DvidMakesThings/HW_BladeCoreMxx/BladeCore-M40/images/BladeCore-M40-Schematics-2.png

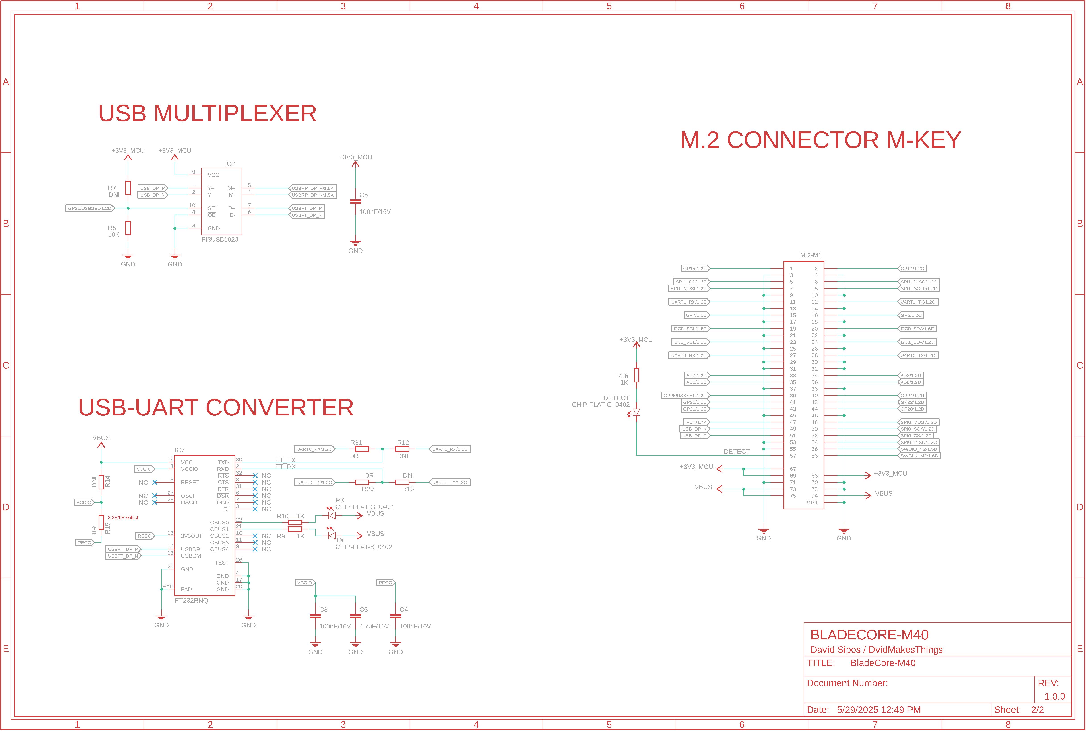
BladeCore-M40/images/BladeCore-M40-Schematics-2.png
