DvidMakesThings/HW_BladeCoreMxx/BladeCore-M40/images/BladeCore-M40_3D-2.png

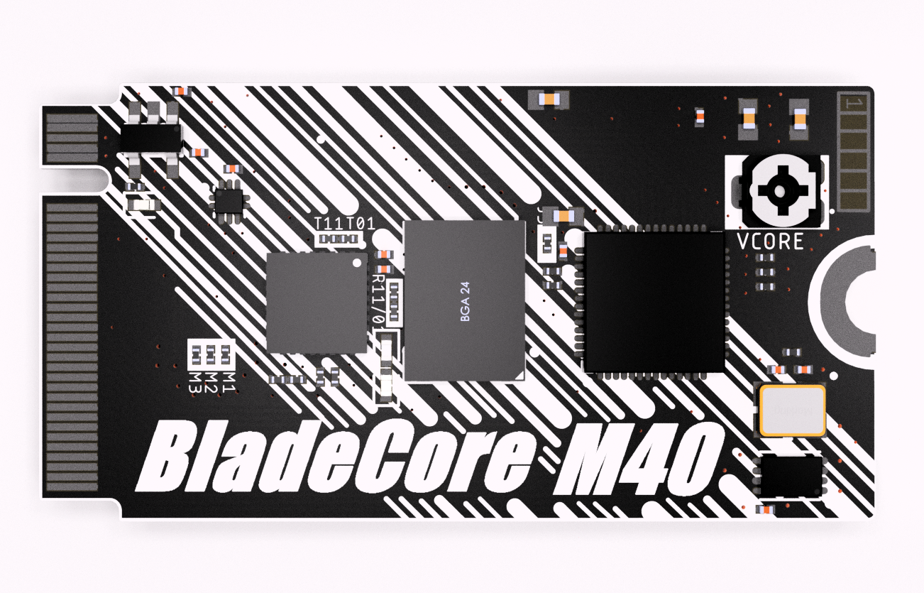
BladeCore-M40/images/BladeCore-M40_3D-2.png
