DvidMakesThings/HW_BladeCoreMxx/BladeCore-M40/images/PCB/Layer-1.png

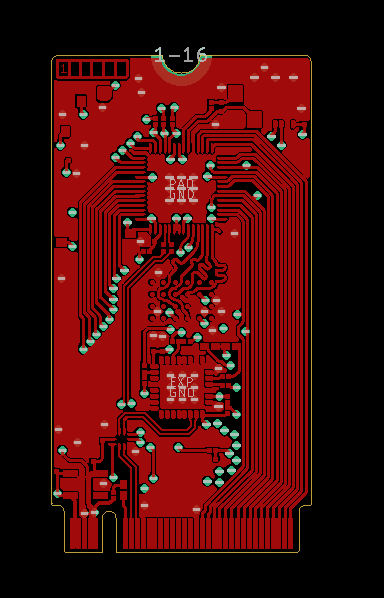
BladeCore-M40/images/PCB/Layer-1.png
