DvidMakesThings/HW_BladeCoreMxx/BladeCore-M40/images/PCB/Layer-2.png

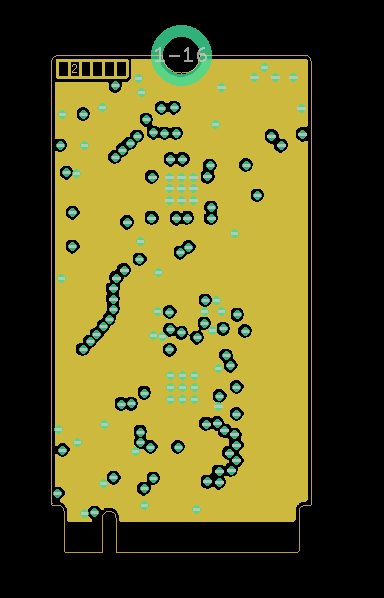
BladeCore-M40/images/PCB/Layer-2.png
