DvidMakesThings/HW_BladeCoreMxx/BladeCore-M40/images/PCB/Layer-3.png

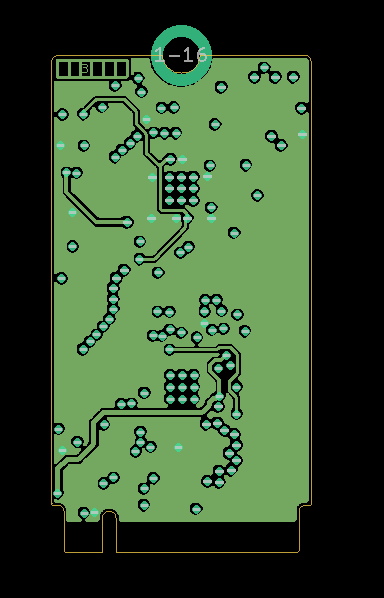
BladeCore-M40/images/PCB/Layer-3.png
