DvidMakesThings/HW_BladeCoreMxx/BladeCore-M40/images/PCB/Layer-4.png

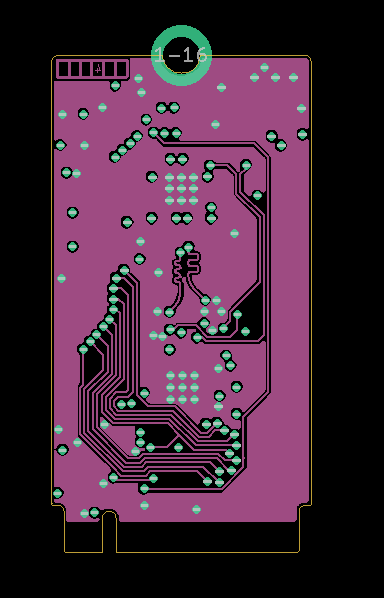
BladeCore-M40/images/PCB/Layer-4.png
