DvidMakesThings/HW_BladeCoreMxx/BladeCore-M40/images/PCB/Layer-6.png

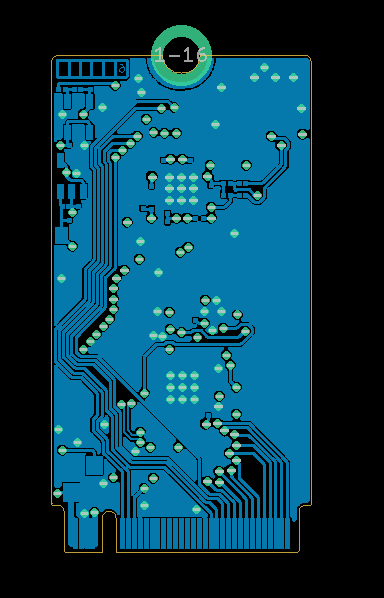
BladeCore-M40/images/PCB/Layer-6.png
