DvidMakesThings/HW_BladeCoreMxx/BladeCore-M40/images/PCB/Silkscreen_Bottom.png

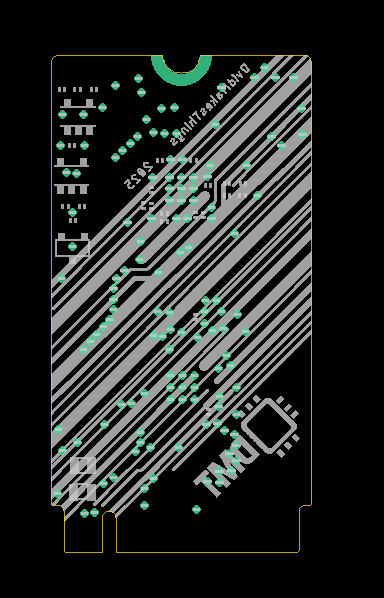
BladeCore-M40/images/PCB/Silkscreen_Bottom.png
