DvidMakesThings/HW_BladeCoreMxx/BladeCore-M40/images/PCB/Silkscreen_Top.png

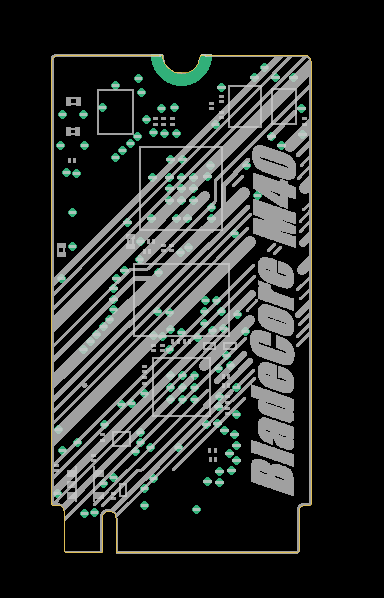
BladeCore-M40/images/PCB/Silkscreen_Top.png
