DvidMakesThings/HW_BladeCoreMxx/BladeCore-M54/src/PDF/BladeCore-M40_Schematics.pdf

# 3.3 VBUS-LDO

A

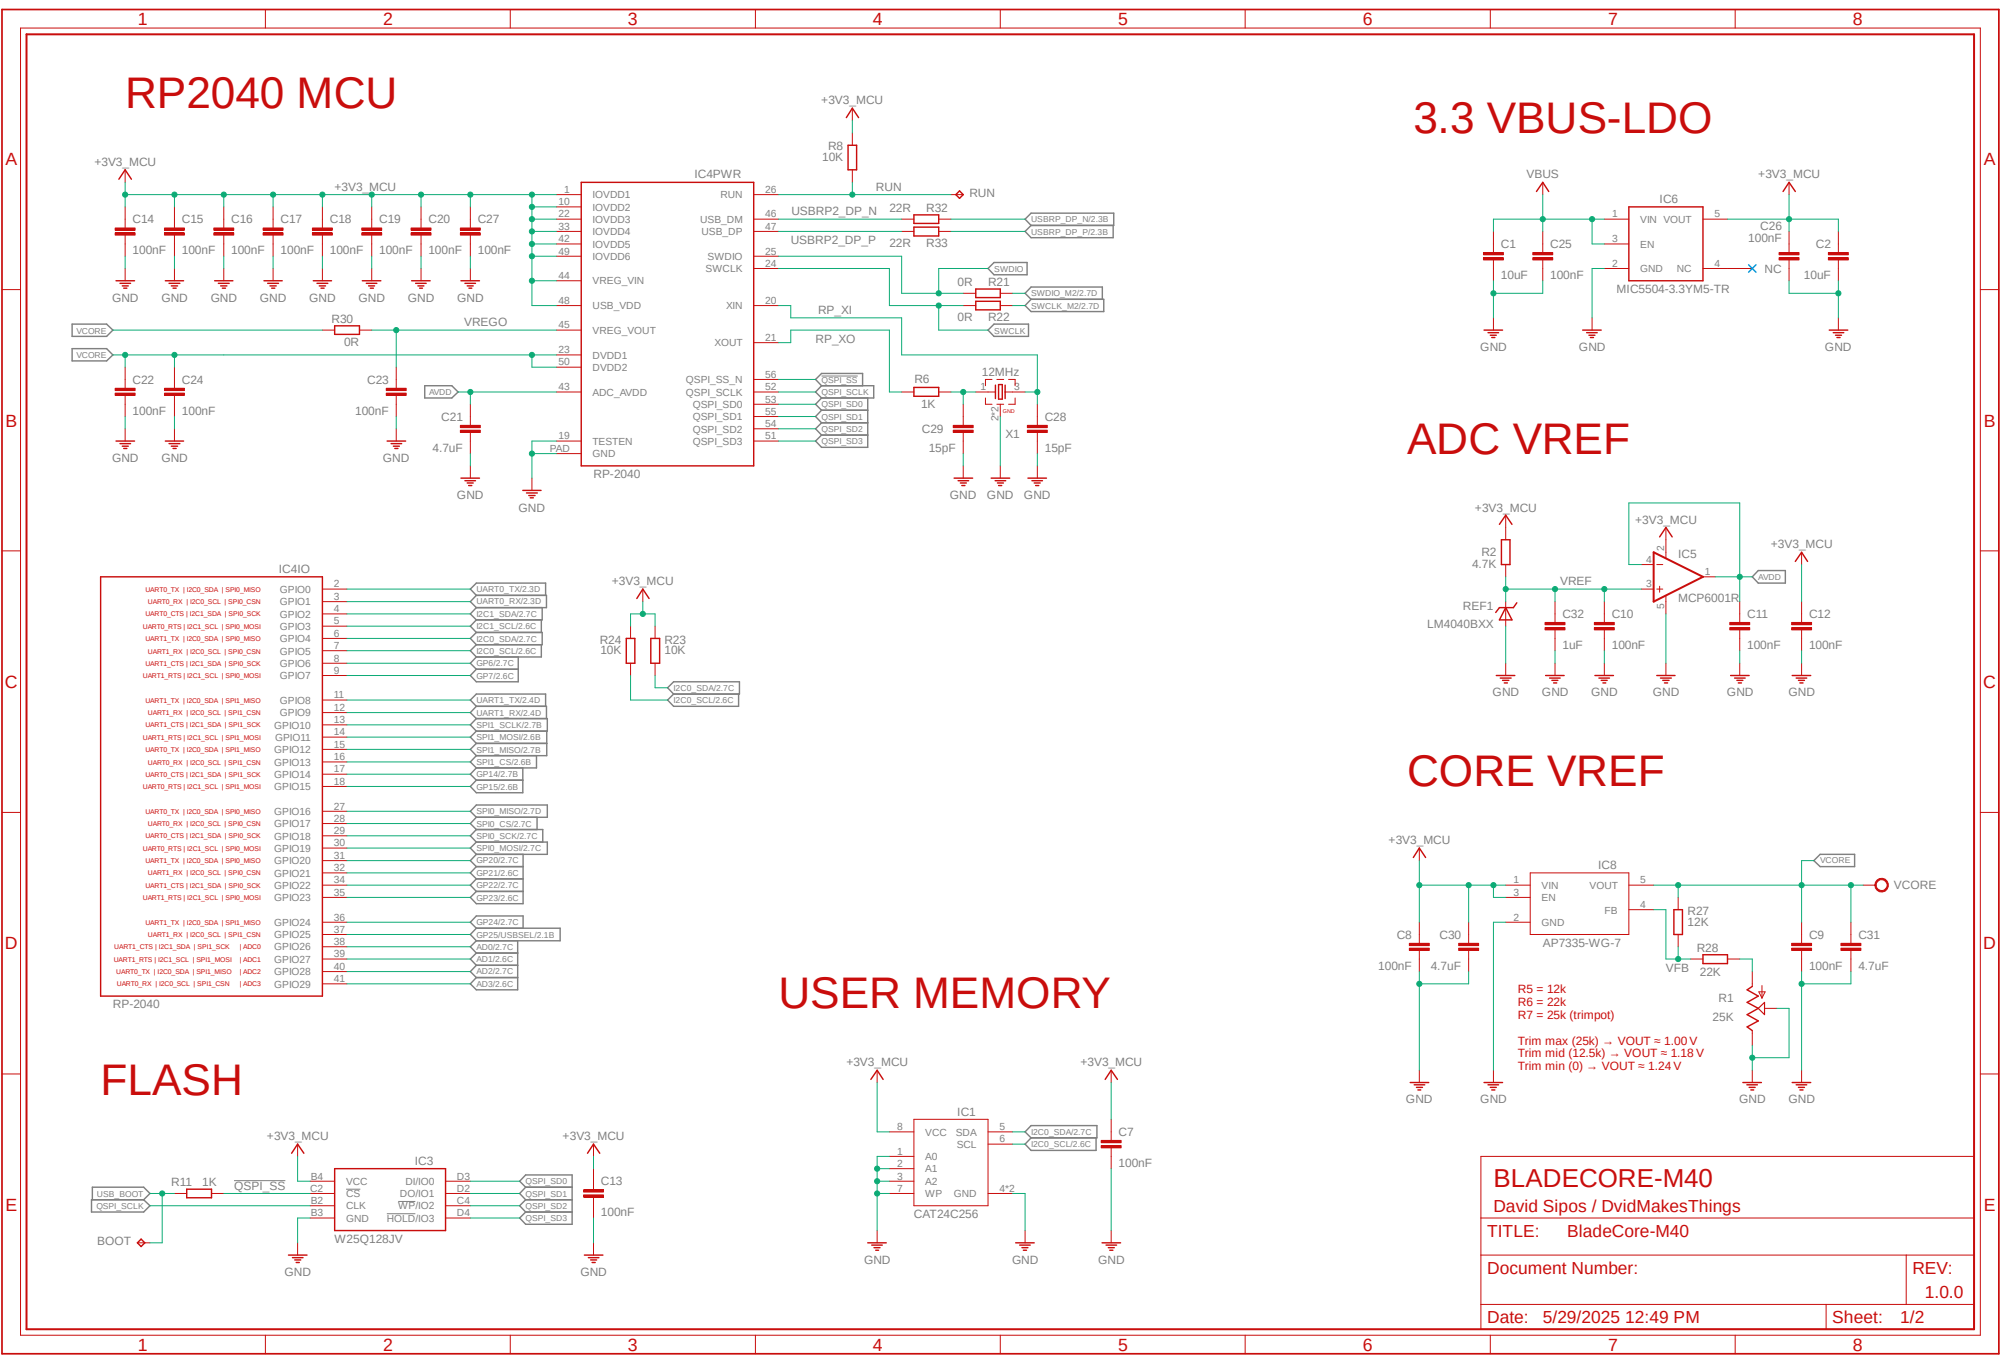
[picture p14: page 1]

RP2040 MCU +3V3_MCU

IOVDD2 10 | 22R R32

Trim min (0) → VOUT ≈ 1.24 V FLASH

# USB MULTIPLEXER M.2 CONNECTOR M-KEY

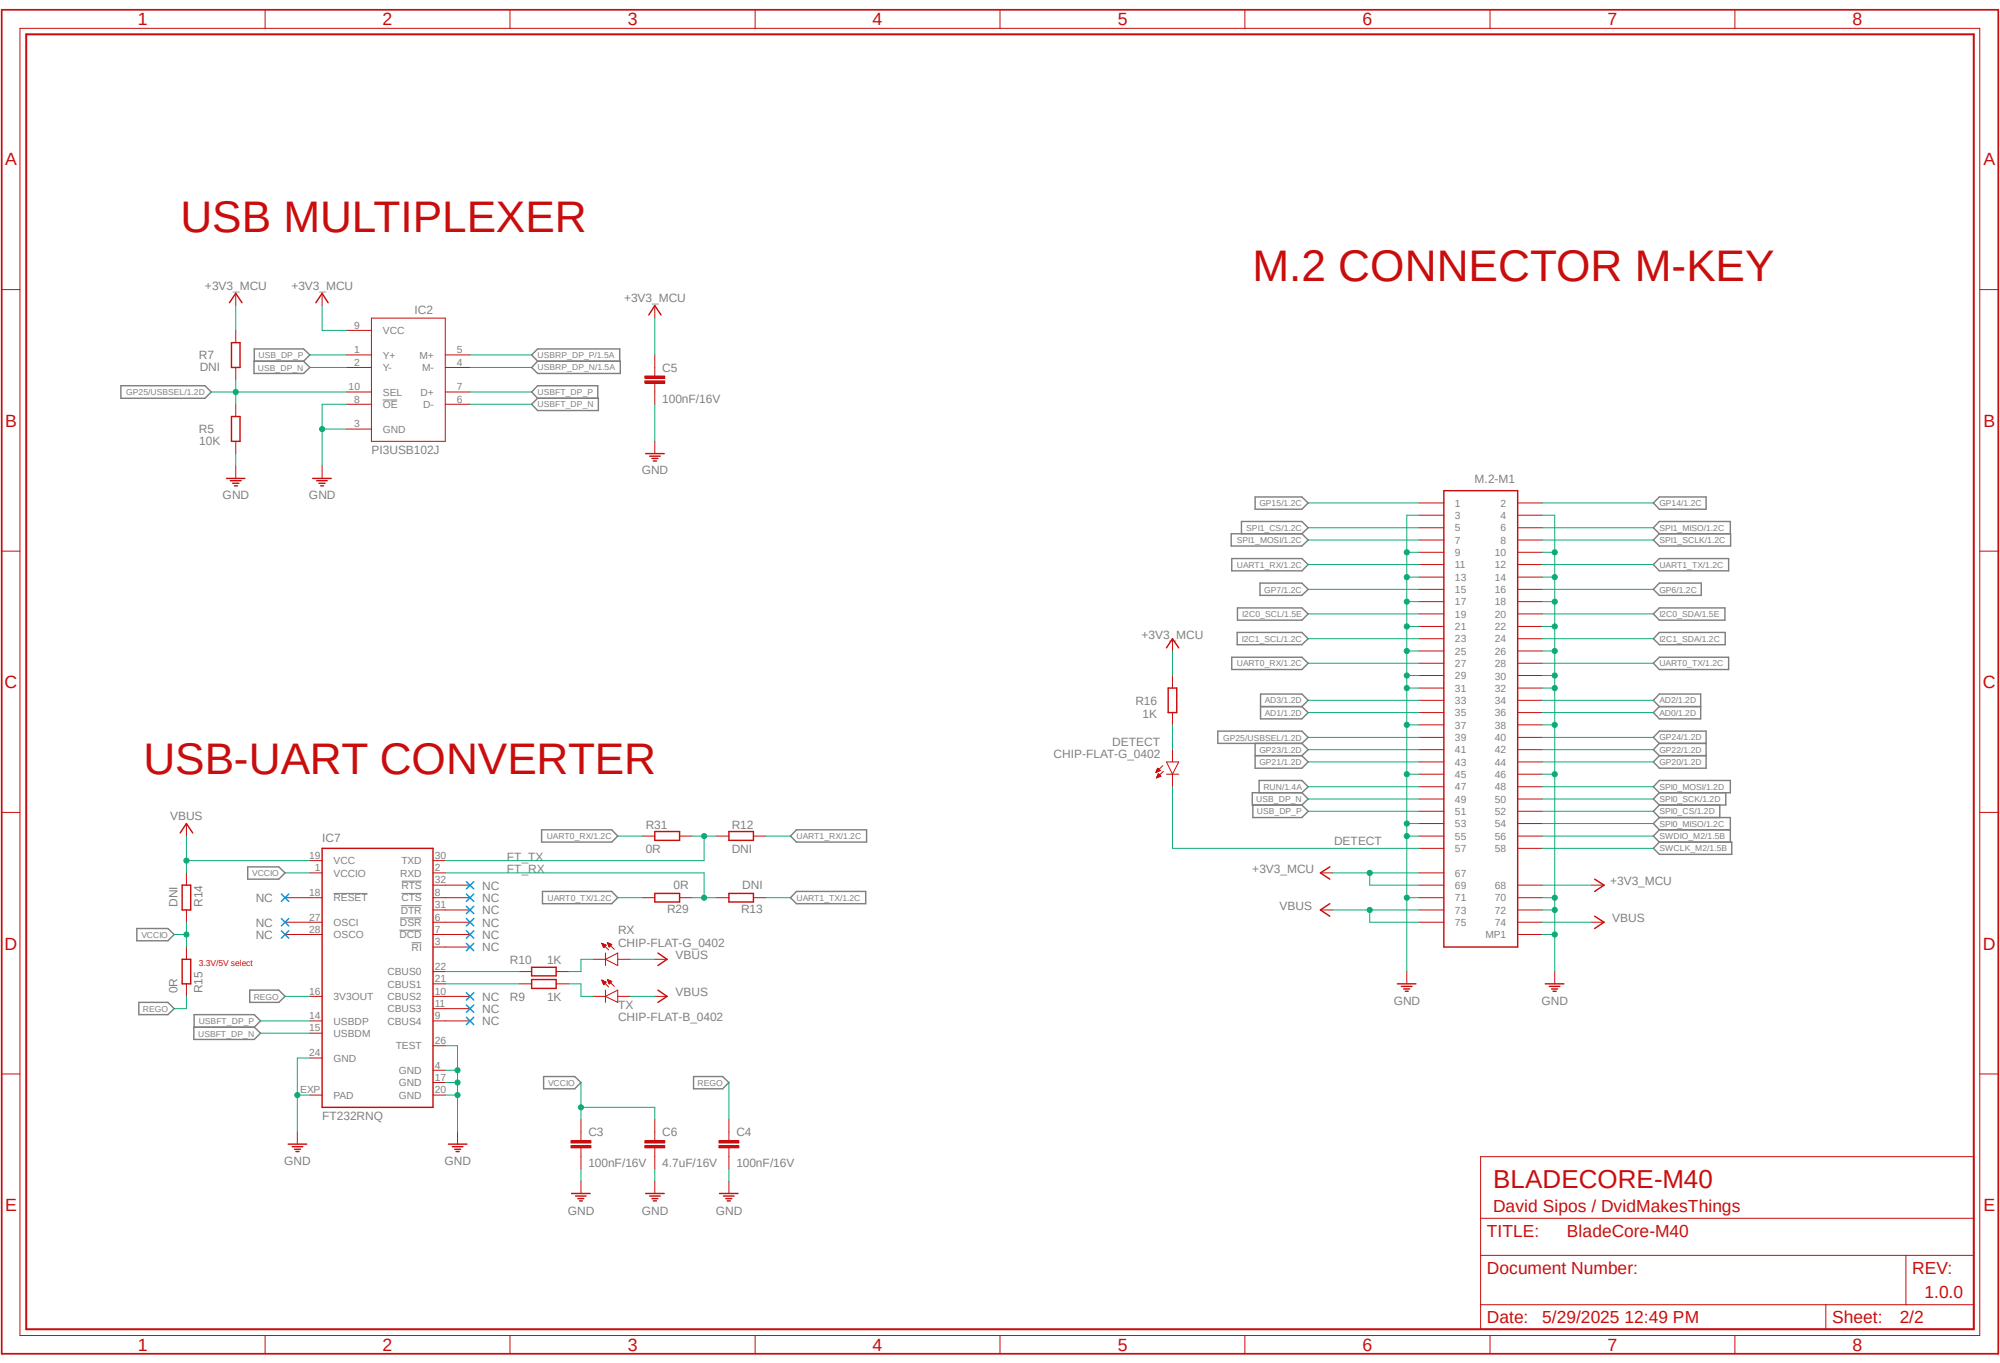
[picture p15: page 2]

Document Number: | REV: 1.0.0

Date: 5/29/2025 12:49 PM | Sheet: 2/2
