DvidMakesThings/HW_BladeCoreMxx/BladeCore-M54/src/HardwareDesign/BladeCore-M54.brd

## EAGLE design BladeCore-M54/src/HardwareDesign/BladeCore-M54.brd (2025-06-02)

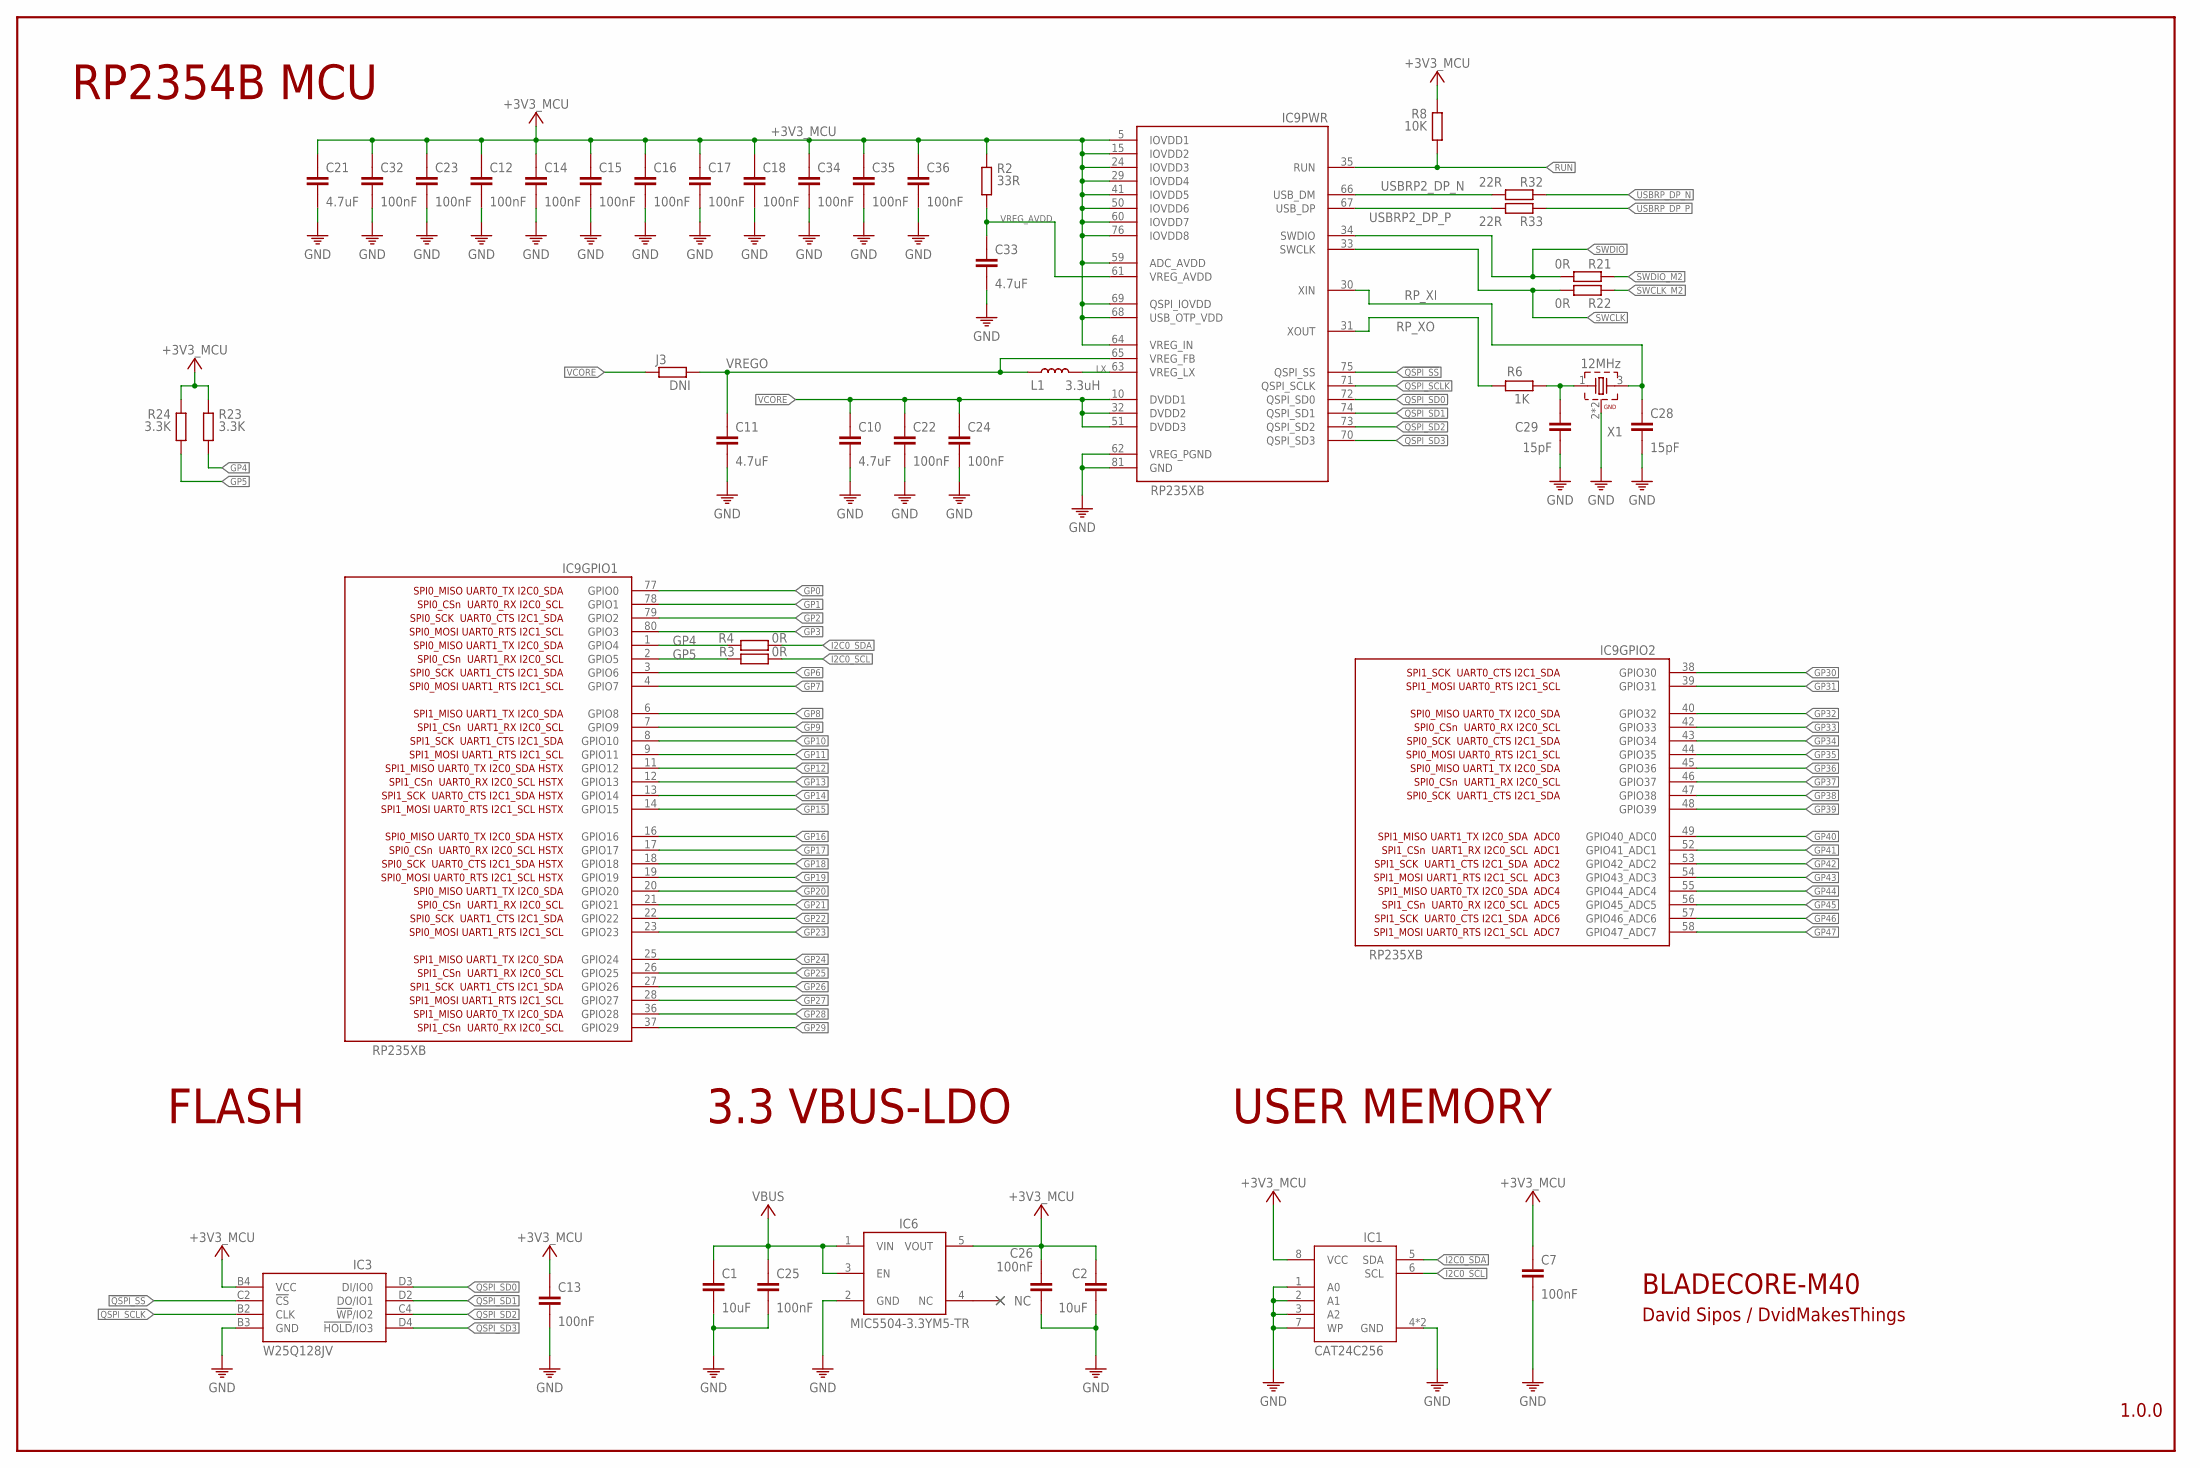
[picture p16: schematic BladeCore-M54.sch, sheet 1]

Parts:
C1, C2: 10uF; 0805
C7, C12, C13, C14, C15, C16, C17, C18, C22, C23, C24, C25, C26, C32, C34, C35, C36: 100nF; 0201
C10, C11, C33: 4.7uF; 0201
C21: 4.7uF; C0402
C28, C29: 15pF; 0201
IC1: CAT24C512HU5IGT3; SON50P300X200X50-9T130X140N
IC3: W25Q128JVCIQ TR; BGA24C100P4X6_800X600X120N
IC6: MIC5504-3.3YM5-TR; SOT23-5
IC9: RP235XB; QFN80-10X10
J3: DNI; R0201
L1: 3.3uH; SRR5228A
R2: 33R; R0201
R3, R4, R21, R22: 0R; R0201
R6: 1K; R0201
R8: 10K; R0201
R23, R24: 3.3K; R0201
R32, R33: 22R; R0201
X1: 12MHz; WE-XTAL_CFPX-180

Connections:
!QSPI_SS: IC3.C2 (!CS), IC9.75 (QSPI_SS)
+3V3_MCU: C2.1, C7.1, C12.1, C13.1, C14.1, C15.1, C16.1, C17.1, C18.1, C21.1, C23.1, C26.1, C32.1, C34.1, C35.1, C36.1, IC1.8 (VCC), IC3.B4 (VCC), IC6.5 (VOUT), IC9.5 (IOVDD1), IC9.15 (IOVDD2), IC9.24 (IOVDD3), IC9.29 (IOVDD4), IC9.41 (IOVDD5), IC9.50 (IOVDD6), IC9.59 (ADC_AVDD), IC9.60 (IOVDD7), IC9.64 (VREG_IN), IC9.68 (USB_OTP_VDD), IC9.69 (QSPI_IOVDD), IC9.76 (IOVDD8), R2.1, R8.1, R23.1, R24.1; also elsewhere on the board
GND: C1.2, C2.2, C7.2, C10.2, C11.2, C12.2, C13.2, C14.2, C15.2, C16.2, C17.2, C18.2, C21.2, C22.2, C23.2, C24.2, C25.2, C26.2, C28.2, C29.2, C32.2, C33.2, C34.2, C35.2, C36.2, IC1.1 (A0), IC1.2 (A1), IC1.3 (A2), IC1.4 (GND), IC1.7 (WP), IC1.9 (GND), IC3.B3 (GND), IC6.2 (GND), IC9.62 (VREG_PGND), IC9.81 (GND), X1.2 (GND), X1.4 (GND); also elsewhere on the board
GP0: IC9.77 (GPIO0); also elsewhere on the board
GP1: IC9.78 (GPIO1); also elsewhere on the board
GP2: IC9.79 (GPIO2); also elsewhere on the board
GP3: IC9.80 (GPIO3); also elsewhere on the board
GP4: IC9.1 (GPIO4), R4.1, R23.2; also elsewhere on the board
GP5: IC9.2 (GPIO5), R3.1, R24.2; also elsewhere on the board
GP6: IC9.3 (GPIO6); also elsewhere on the board
GP7: IC9.4 (GPIO7); also elsewhere on the board
GP8: IC9.6 (GPIO8); also elsewhere on the board
GP9: IC9.7 (GPIO9); also elsewhere on the board
GP10: IC9.8 (GPIO10); also elsewhere on the board
GP11: IC9.9 (GPIO11); also elsewhere on the board
GP12: IC9.11 (GPIO12); also elsewhere on the board
GP13: IC9.12 (GPIO13); also elsewhere on the board
GP14: IC9.13 (GPIO14); also elsewhere on the board
GP15: IC9.14 (GPIO15); also elsewhere on the board
GP16: IC9.16 (GPIO16); also elsewhere on the board
GP17: IC9.17 (GPIO17); also elsewhere on the board
GP18: IC9.18 (GPIO18); also elsewhere on the board
GP19: IC9.19 (GPIO19); also elsewhere on the board
GP20: IC9.20 (GPIO20); also elsewhere on the board
GP21: IC9.21 (GPIO21); also elsewhere on the board
GP22: IC9.22 (GPIO22); also elsewhere on the board
GP23: IC9.23 (GPIO23); also elsewhere on the board
GP24: IC9.25 (GPIO24); also elsewhere on the board
GP25: IC9.26 (GPIO25); also elsewhere on the board
GP26: IC9.27 (GPIO26); also elsewhere on the board
GP27: IC9.28 (GPIO27); also elsewhere on the board
GP28: IC9.36 (GPIO28); also elsewhere on the board
GP29: IC9.37 (GPIO29); also elsewhere on the board
GP30: IC9.38 (GPIO30); also elsewhere on the board
GP31: IC9.39 (GPIO31); also elsewhere on the board
GP32: IC9.40 (GPIO32); also elsewhere on the board
GP33: IC9.42 (GPIO33); also elsewhere on the board
GP34: IC9.43 (GPIO34); also elsewhere on the board
GP35: IC9.44 (GPIO35); also elsewhere on the board
GP36: IC9.45 (GPIO36); also elsewhere on the board
GP37: IC9.46 (GPIO37); also elsewhere on the board
GP38: IC9.47 (GPIO38); also elsewhere on the board
GP39: IC9.48 (GPIO39); also elsewhere on the board
GP40: IC9.49 (GPIO40_ADC0); also elsewhere on the board
GP41: IC9.52 (GPIO41_ADC1); also elsewhere on the board
GP42: IC9.53 (GPIO42_ADC2); also elsewhere on the board
GP43: IC9.54 (GPIO43_ADC3); also elsewhere on the board
GP44: IC9.55 (GPIO44_ADC4); also elsewhere on the board
GP45: IC9.56 (GPIO45_ADC5); also elsewhere on the board
GP46: IC9.57 (GPIO46_ADC6); also elsewhere on the board
GP47: IC9.58 (GPIO47_ADC7); also elsewhere on the board
I2C0_SCL: IC1.6 (SCL), R3.2
I2C0_SDA: IC1.5 (SDA), R4.2
LX: IC9.63 (VREG_LX), L1.2
unnamed: C29.1, R6.1, X1.1
QSPI_SCLK: IC3.B2 (CLK), IC9.71 (QSPI_SCLK)
QSPI_SD0: IC3.D3 (DI/IO0), IC9.72 (QSPI_SD0)
QSPI_SD1: IC3.D2 (DO/IO1), IC9.74 (QSPI_SD1)
QSPI_SD2: IC3.C4 (!WP!/IO2), IC9.73 (QSPI_SD2)
QSPI_SD3: IC3.D4 (!HOLD!/IO3), IC9.70 (QSPI_SD3)
RP_XI: C28.1, IC9.30 (XIN), X1.3 (2)
RP_XO: IC9.31 (XOUT), R6.2
RUN: IC9.35 (RUN), R8.2; also elsewhere on the board
SWCLK: IC9.33 (SWCLK), R22.2
SWCLK_M2: R22.1; also elsewhere on the board
SWDIO: IC9.34 (SWDIO), R21.2
SWDIO_M2: R21.1; also elsewhere on the board
USBRP2_DP_N: IC9.66 (USB_DM), R32.2
USBRP2_DP_P: IC9.67 (USB_DP), R33.2
USBRP_DP_N: R32.1; also elsewhere on the board
USBRP_DP_P: R33.1; also elsewhere on the board
VBUS: C1.1, C25.1, IC6.1 (VIN), IC6.3 (EN); also elsewhere on the board
VCORE: C10.1, C22.1, C24.1, IC9.10 (DVDD1), IC9.32 (DVDD2), IC9.51 (DVDD3), J3.2
VREGO: C11.1, IC9.65 (VREG_FB), J3.1, L1.1
VREG_AVDD: C33.1, IC9.61 (VREG_AVDD), R2.2

Notes on the sheet:
RP2354B MCU
BLADECORE-M40
1.0.0
David Sipos / DvidMakesThings
3.3 VBUS-LDO
FLASH
USER MEMORY

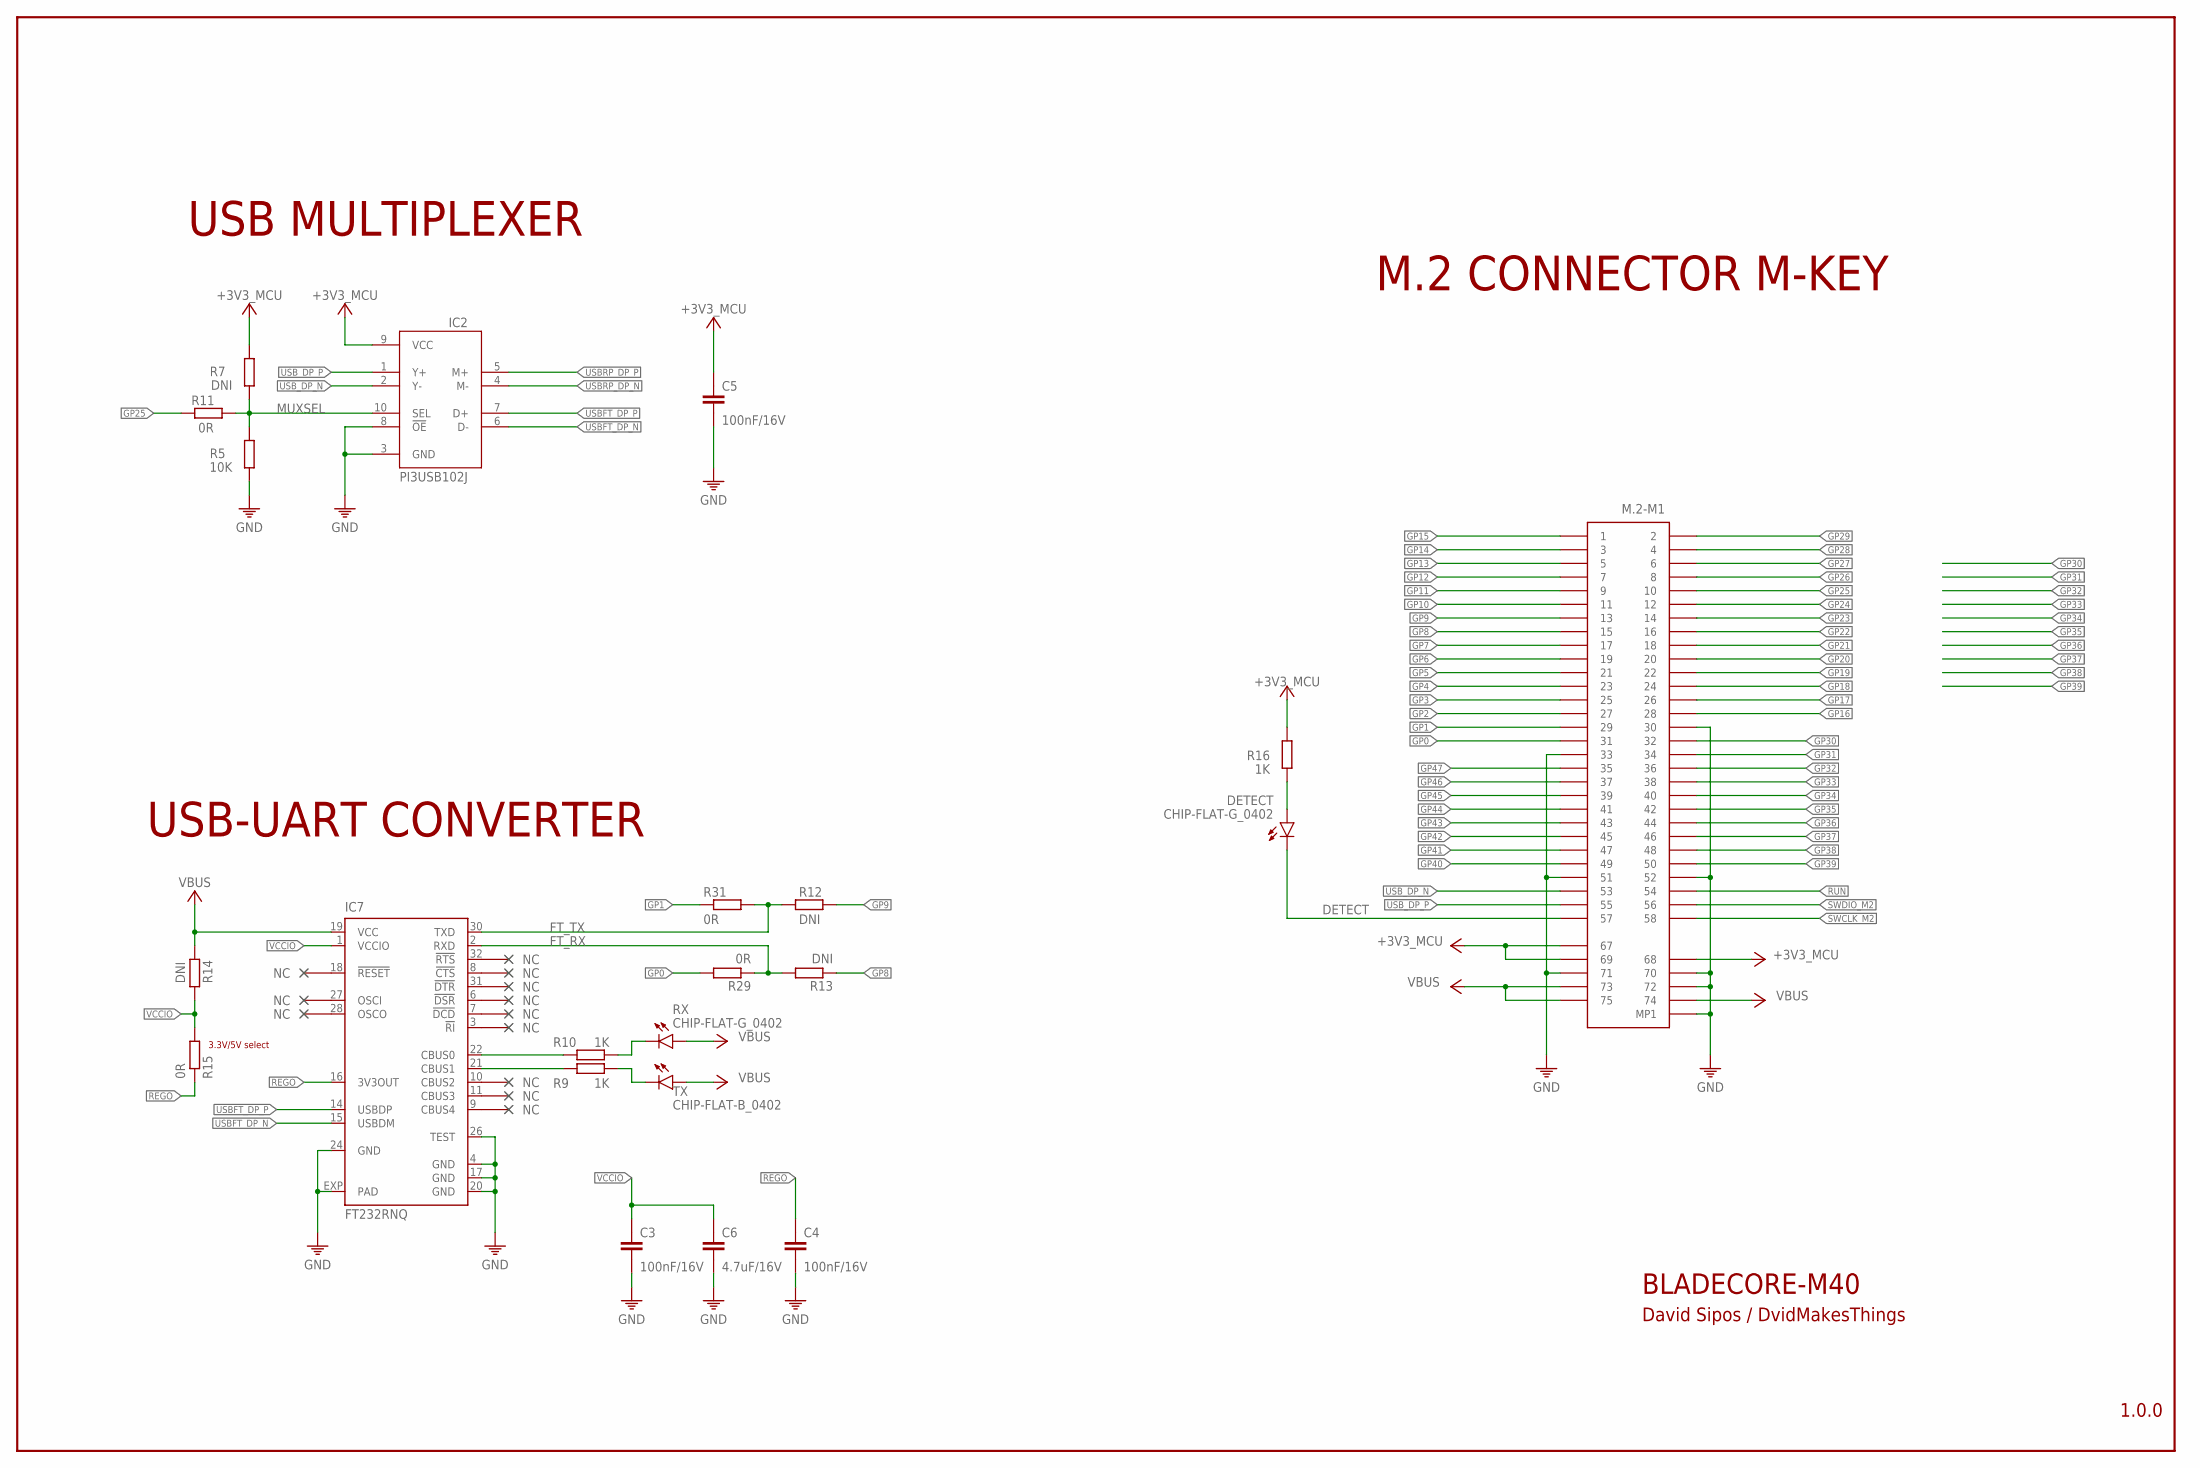
[picture p17: schematic BladeCore-M54.sch, sheet 2]

Parts:
C3, C4, C5: 100nF/16V; 0201
C6: 4.7uF/16V; 0201
DETECT: CHIP-FLAT-G_0402; LEDC1005X25N_FLAT-G
IC2: PI3USB102J; QFN40P120X140X35-10N
IC7: FT232RNQ; QFN32
M.2-M1: M.2-M-KEY
R5: 10K; R0201
R7, R12, R13, R14: DNI; R0201
R9, R10, R16: 1K; R0201
R11, R15, R29, R31: 0R; R0201
RX: CHIP-FLAT-G_0402; LEDC1005X25N_FLAT-G
TX: CHIP-FLAT-B_0402; LEDC1005X25N_FLAT-B

Connections:
+3V3_MCU: C5.1, IC2.9 (VCC), M.2-M1.P$67 (67), M.2-M1.P$68 (68), M.2-M1.P$69 (69), R7.2, R16.2; also elsewhere on the board
DETECT: DETECT.C, M.2-M1.P$57 (57)
FT_RX: IC7.2 (RXD), R13.2, R29.1
FT_TX: IC7.30 (TXD), R12.1, R31.2
GND: C3.2, C4.2, C5.2, C6.2, IC2.3 (GND), IC2.8 (!OE), IC7.4 (GND), IC7.17 (GND), IC7.20 (GND), IC7.24 (GND), IC7.26 (TEST), IC7.EXP (PAD), M.2-M1.MT1 (MP1), M.2-M1.P$30 (30), M.2-M1.P$33 (33), M.2-M1.P$51 (51), M.2-M1.P$52 (52), M.2-M1.P$70 (70), M.2-M1.P$71 (71), M.2-M1.P$72 (72), R5.1; also elsewhere on the board
GP0: M.2-M1.P$31 (31), R29.2; also elsewhere on the board
GP1: M.2-M1.P$29 (29), R31.1; also elsewhere on the board
GP2: M.2-M1.P$27 (27); also elsewhere on the board
GP3: M.2-M1.P$25 (25); also elsewhere on the board
GP4: M.2-M1.P$23 (23); also elsewhere on the board
GP5: M.2-M1.P$21 (21); also elsewhere on the board
GP6: M.2-M1.P$19 (19); also elsewhere on the board
GP7: M.2-M1.P$17 (17); also elsewhere on the board
GP8: M.2-M1.P$15 (15), R13.1; also elsewhere on the board
GP9: M.2-M1.P$13 (13), R12.2; also elsewhere on the board
GP10: M.2-M1.P$11 (11); also elsewhere on the board
GP11: M.2-M1.P$9 (9); also elsewhere on the board
GP12: M.2-M1.P$7 (7); also elsewhere on the board
GP13: M.2-M1.P$5 (5); also elsewhere on the board
GP14: M.2-M1.P$3 (3); also elsewhere on the board
GP15: M.2-M1.P$1 (1); also elsewhere on the board
GP16: M.2-M1.P$28 (28); also elsewhere on the board
GP17: M.2-M1.P$26 (26); also elsewhere on the board
GP18: M.2-M1.P$24 (24); also elsewhere on the board
GP19: M.2-M1.P$22 (22); also elsewhere on the board
GP20: M.2-M1.P$20 (20); also elsewhere on the board
GP21: M.2-M1.P$18 (18); also elsewhere on the board
GP22: M.2-M1.P$16 (16); also elsewhere on the board
GP23: M.2-M1.P$14 (14); also elsewhere on the board
GP24: M.2-M1.P$12 (12); also elsewhere on the board
GP25: M.2-M1.P$10 (10), R11.2; also elsewhere on the board
GP26: M.2-M1.P$8 (8); also elsewhere on the board
GP27: M.2-M1.P$6 (6); also elsewhere on the board
GP28: M.2-M1.P$4 (4); also elsewhere on the board
GP29: M.2-M1.P$2 (2); also elsewhere on the board
GP30: M.2-M1.P$32 (32); also elsewhere on the board
GP31: M.2-M1.P$34 (34); also elsewhere on the board
GP32: M.2-M1.P$36 (36); also elsewhere on the board
GP33: M.2-M1.P$38 (38); also elsewhere on the board
GP34: M.2-M1.P$40 (40); also elsewhere on the board
GP35: M.2-M1.P$42 (42); also elsewhere on the board
GP36: M.2-M1.P$44 (44); also elsewhere on the board
GP37: M.2-M1.P$46 (46); also elsewhere on the board
GP38: M.2-M1.P$48 (48); also elsewhere on the board
GP39: M.2-M1.P$50 (50); also elsewhere on the board
GP40: M.2-M1.P$49 (49); also elsewhere on the board
GP41: M.2-M1.P$47 (47); also elsewhere on the board
GP42: M.2-M1.P$45 (45); also elsewhere on the board
GP43: M.2-M1.P$43 (43); also elsewhere on the board
GP44: M.2-M1.P$41 (41); also elsewhere on the board
GP45: M.2-M1.P$39 (39); also elsewhere on the board
GP46: M.2-M1.P$37 (37); also elsewhere on the board
GP47: M.2-M1.P$35 (35); also elsewhere on the board
MUXSEL: IC2.10 (SEL), R5.2, R7.1, R11.1
unnamed: DETECT.A, R16.1
unnamed: IC7.22 (CBUS0), R10.1
unnamed: IC7.21 (CBUS1), R9.1
unnamed: R9.2, TX.C
unnamed: R10.2, RX.C
REGO: C4.1, IC7.16 (3V3OUT), R15.1
RUN: M.2-M1.P$54 (54); also elsewhere on the board
SWCLK_M2: M.2-M1.P$58 (58); also elsewhere on the board
SWDIO_M2: M.2-M1.P$56 (56); also elsewhere on the board
USBFT_DP_N: IC2.6 (D-), IC7.15 (USBDM)
USBFT_DP_P: IC2.7 (D+), IC7.14 (USBDP)
USBRP_DP_N: IC2.4 (M-); also elsewhere on the board
USBRP_DP_P: IC2.5 (M+); also elsewhere on the board
USB_DP_N: IC2.2 (Y-), M.2-M1.P$53 (53)
USB_DP_P: IC2.1 (Y+), M.2-M1.P$55 (55)
VBUS: IC7.19 (VCC), M.2-M1.P$73 (73), M.2-M1.P$74 (74), M.2-M1.P$75 (75), R14.2, RX.A, TX.A; also elsewhere on the board
VCCIO: C3.1, C6.1, IC7.1 (VCCIO), R14.1, R15.2

Notes on the sheet:
3.3V/5V select
USB MULTIPLEXER
USB-UART CONVERTER
M.2 CONNECTOR M-KEY
BLADECORE-M40
1.0.0
David Sipos / DvidMakesThings

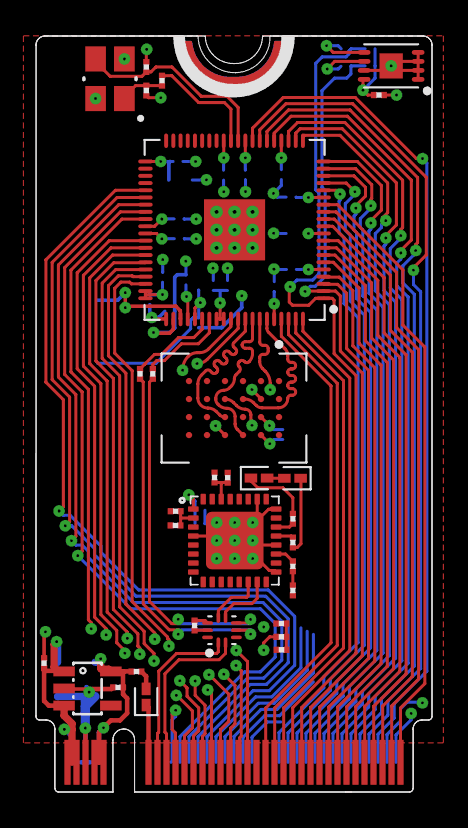
[picture p18: board BladeCore-M54.brd from above]

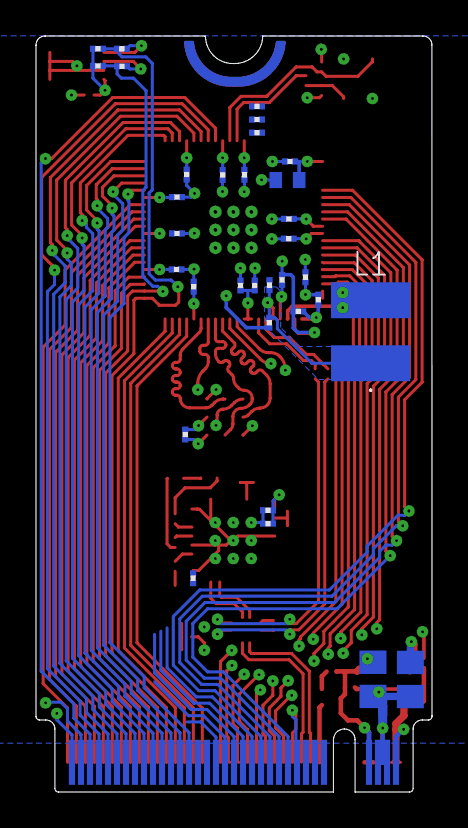
[picture p19: board BladeCore-M54.brd from below]

Board: 6 copper layers, 22.0 x 42.0 mm, 66 parts (34 on the bottom side), 90 nets.

Other parts of the board:
U$1: DMT
