DvidMakesThings/HW_BladeCoreMxx/BladeCore-M40/src/HardwareDesign/BladeCore-M40.brd

## EAGLE design BladeCore-M40/src/HardwareDesign/BladeCore-M40.brd (2025-06-02)

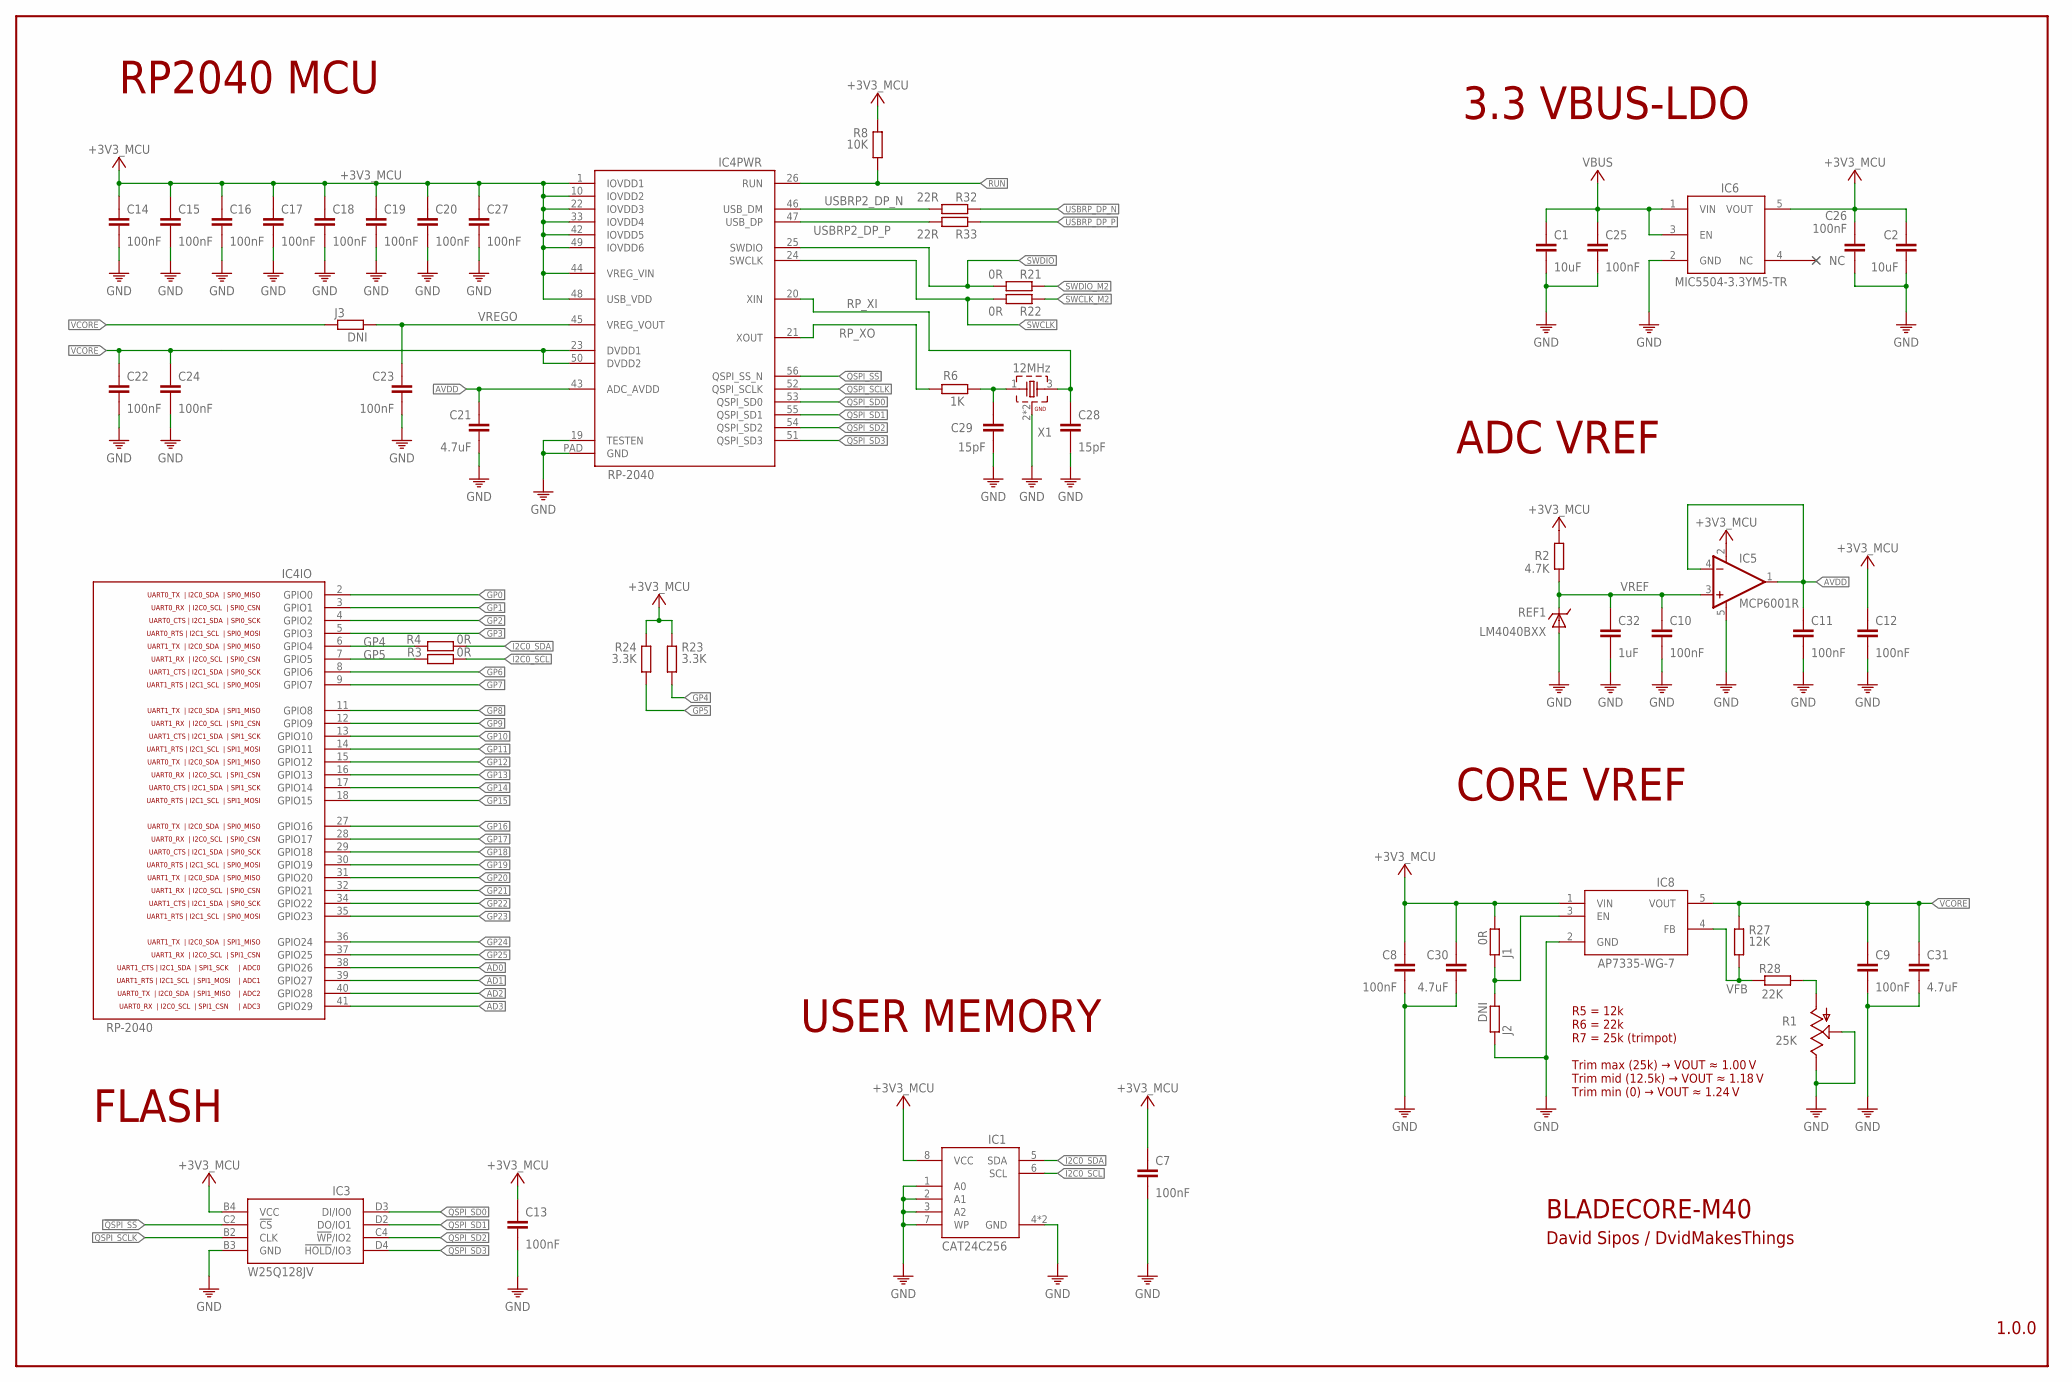
[picture p20: schematic BladeCore-M40.sch, sheet 1]

Parts:
C1, C2: 10uF; 0805
C7, C8, C9, C10, C11, C12, C13, C14, C15, C16, C17, C18, C19, C20, C22, C23, C24, C25, C26, C27: 100nF; 0201
C21, C30, C31: 4.7uF; C0402
C28, C29: 15pF; 0201
C32: 1uF; C0402
IC1: CAT24C512HU5IGT3; SON50P300X200X50-9T130X140N
IC3: W25Q128JVCIQ TR; BGA24C100P4X6_800X600X120N
IC4: RP-2040; QFN56
IC5: MCP6001R; SOT23-5
IC6: MIC5504-3.3YM5-TR; SOT23-5
IC8: AP7335-WG-7; SOT23-5
J1: 0R; R0201
J2, J3: DNI; R0201
R1: 25K; SMD_TRIMMER
R2: 4.7K; R0201
R3, R4, R21, R22: 0R; R0201
R6: 1K; R0201
R8: 10K; R0201
R23, R24: 3.3K; R0201
R27: 12K; R0201
R28: 22K; R0201
R32, R33: 22R; R0201
REF1: LM4040BXX; SOT23
X1: 12MHz; WE-XTAL_CFPX-180

Connections:
!QSPI_SS: IC3.C2 (!CS), IC4.56 (QSPI_SS_N)
+3V3_MCU: C2.1, C7.1, C8.1, C12.1, C13.1, C14.1, C15.1, C16.1, C17.1, C18.1, C19.1, C20.1, C26.1, C27.1, C30.1, IC1.8 (VCC), IC3.B4 (VCC), IC4.1 (IOVDD1), IC4.10 (IOVDD2), IC4.22 (IOVDD3), IC4.33 (IOVDD4), IC4.42 (IOVDD5), IC4.44 (VREG_VIN), IC4.48 (USB_VDD), IC4.49 (IOVDD6), IC5.2 (V+), IC6.5 (VOUT), IC8.1 (VIN), J1.1, R2.2, R8.1, R23.1, R24.1; also elsewhere on the board
AD0: IC4.38 (GPIO26); also elsewhere on the board
AD1: IC4.39 (GPIO27); also elsewhere on the board
AD2: IC4.40 (GPIO28); also elsewhere on the board
AD3: IC4.41 (GPIO29); also elsewhere on the board
AVDD: C11.1, C21.1, IC4.43 (ADC_AVDD), IC5.1 (OUT), IC5.4 (-IN)
FBTRIM: R1.3, R28.2
GND: C1.2, C2.2, C7.2, C8.2, C9.2, C10.2, C11.2, C12.2, C13.2, C14.2, C15.2, C16.2, C17.2, C18.2, C19.2, C20.2, C21.2, C22.2, C23.2, C24.2, C25.2, C26.2, C27.2, C28.2, C29.2, C30.2, C31.2, C32.2, IC1.1 (A0), IC1.2 (A1), IC1.3 (A2), IC1.4 (GND), IC1.7 (WP), IC1.9 (GND), IC3.B3 (GND), IC4.19 (TESTEN), IC4.PAD (GND), IC5.5 (V-), IC6.2 (GND), IC8.2 (GND), J2.2, R1.1, R1.2, REF1.2 (A), REF1.3 (A), X1.2 (GND), X1.4 (GND); also elsewhere on the board
GP0: IC4.2 (GPIO0); also elsewhere on the board
GP1: IC4.3 (GPIO1); also elsewhere on the board
GP2: IC4.4 (GPIO2); also elsewhere on the board
GP3: IC4.5 (GPIO3); also elsewhere on the board
GP4: IC4.6 (GPIO4), R4.1, R23.2; also elsewhere on the board
GP5: IC4.7 (GPIO5), R3.1, R24.2; also elsewhere on the board
GP6: IC4.8 (GPIO6); also elsewhere on the board
GP7: IC4.9 (GPIO7); also elsewhere on the board
GP8: IC4.11 (GPIO8); also elsewhere on the board
GP9: IC4.12 (GPIO9); also elsewhere on the board
GP10: IC4.13 (GPIO10); also elsewhere on the board
GP11: IC4.14 (GPIO11); also elsewhere on the board
GP12: IC4.15 (GPIO12); also elsewhere on the board
GP13: IC4.16 (GPIO13); also elsewhere on the board
GP14: IC4.17 (GPIO14); also elsewhere on the board
GP15: IC4.18 (GPIO15); also elsewhere on the board
GP16: IC4.27 (GPIO16); also elsewhere on the board
GP17: IC4.28 (GPIO17); also elsewhere on the board
GP18: IC4.29 (GPIO18); also elsewhere on the board
GP19: IC4.30 (GPIO19); also elsewhere on the board
GP20: IC4.31 (GPIO20); also elsewhere on the board
GP21: IC4.32 (GPIO21); also elsewhere on the board
GP22: IC4.34 (GPIO22); also elsewhere on the board
GP23: IC4.35 (GPIO23); also elsewhere on the board
GP24: IC4.36 (GPIO24); also elsewhere on the board
GP25: IC4.37 (GPIO25); also elsewhere on the board
I2C0_SCL: IC1.6 (SCL), R3.2
I2C0_SDA: IC1.5 (SDA), R4.2
unnamed: IC8.3 (EN), J1.2, J2.1
unnamed: C29.1, R6.1, X1.1
QSPI_SCLK: IC3.B2 (CLK), IC4.52 (QSPI_SCLK)
QSPI_SD0: IC3.D3 (DI/IO0), IC4.53 (QSPI_SD0)
QSPI_SD1: IC3.D2 (DO/IO1), IC4.55 (QSPI_SD1)
QSPI_SD2: IC3.C4 (!WP!/IO2), IC4.54 (QSPI_SD2)
QSPI_SD3: IC3.D4 (!HOLD!/IO3), IC4.51 (QSPI_SD3)
RP_XI: C28.1, IC4.20 (XIN), X1.3 (2)
RP_XO: IC4.21 (XOUT), R6.2
RUN: IC4.26 (RUN), R8.2; also elsewhere on the board
SWCLK: IC4.24 (SWCLK), R22.2
SWCLK_M2: R22.1; also elsewhere on the board
SWDIO: IC4.25 (SWDIO), R21.2
SWDIO_M2: R21.1; also elsewhere on the board
USBRP2_DP_N: IC4.46 (USB_DM), R32.2
USBRP2_DP_P: IC4.47 (USB_DP), R33.2
USBRP_DP_N: R32.1; also elsewhere on the board
USBRP_DP_P: R33.1; also elsewhere on the board
VBUS: C1.1, C25.1, IC6.1 (VIN), IC6.3 (EN); also elsewhere on the board
VCORE: C9.1, C22.1, C24.1, C31.1, IC4.23 (DVDD1), IC4.50 (DVDD2), IC8.5 (VOUT), J3.2, R27.1
VFB: IC8.4 (FB), R27.2, R28.1
VREF: C10.1, C32.1, IC5.3 (+IN), R2.1, REF1.1 (C)
VREGO: C23.1, IC4.45 (VREG_VOUT), J3.1

Notes on the sheet:
RP2040 MCU
ADC VREF
BLADECORE-M40
1.0.0
David Sipos / DvidMakesThings
3.3 VBUS-LDO
CORE VREF
R5 = 12k R6 = 22k R7 = 25k (trimpot) Trim max (25k) → VOUT ≈ 1.00 V Trim mid (12.5k) → VOUT ≈ 1.18 V Trim min (0) → VOUT ≈ 1.24 V
FLASH
USER MEMORY
