DvidMakesThings/HW_BladeCoreMxx/BladeCore-M40/src/HardwareDesign/BladeCore-M40.brd

## EAGLE design BladeCore-M40/src/HardwareDesign/BladeCore-M40.brd (continued)

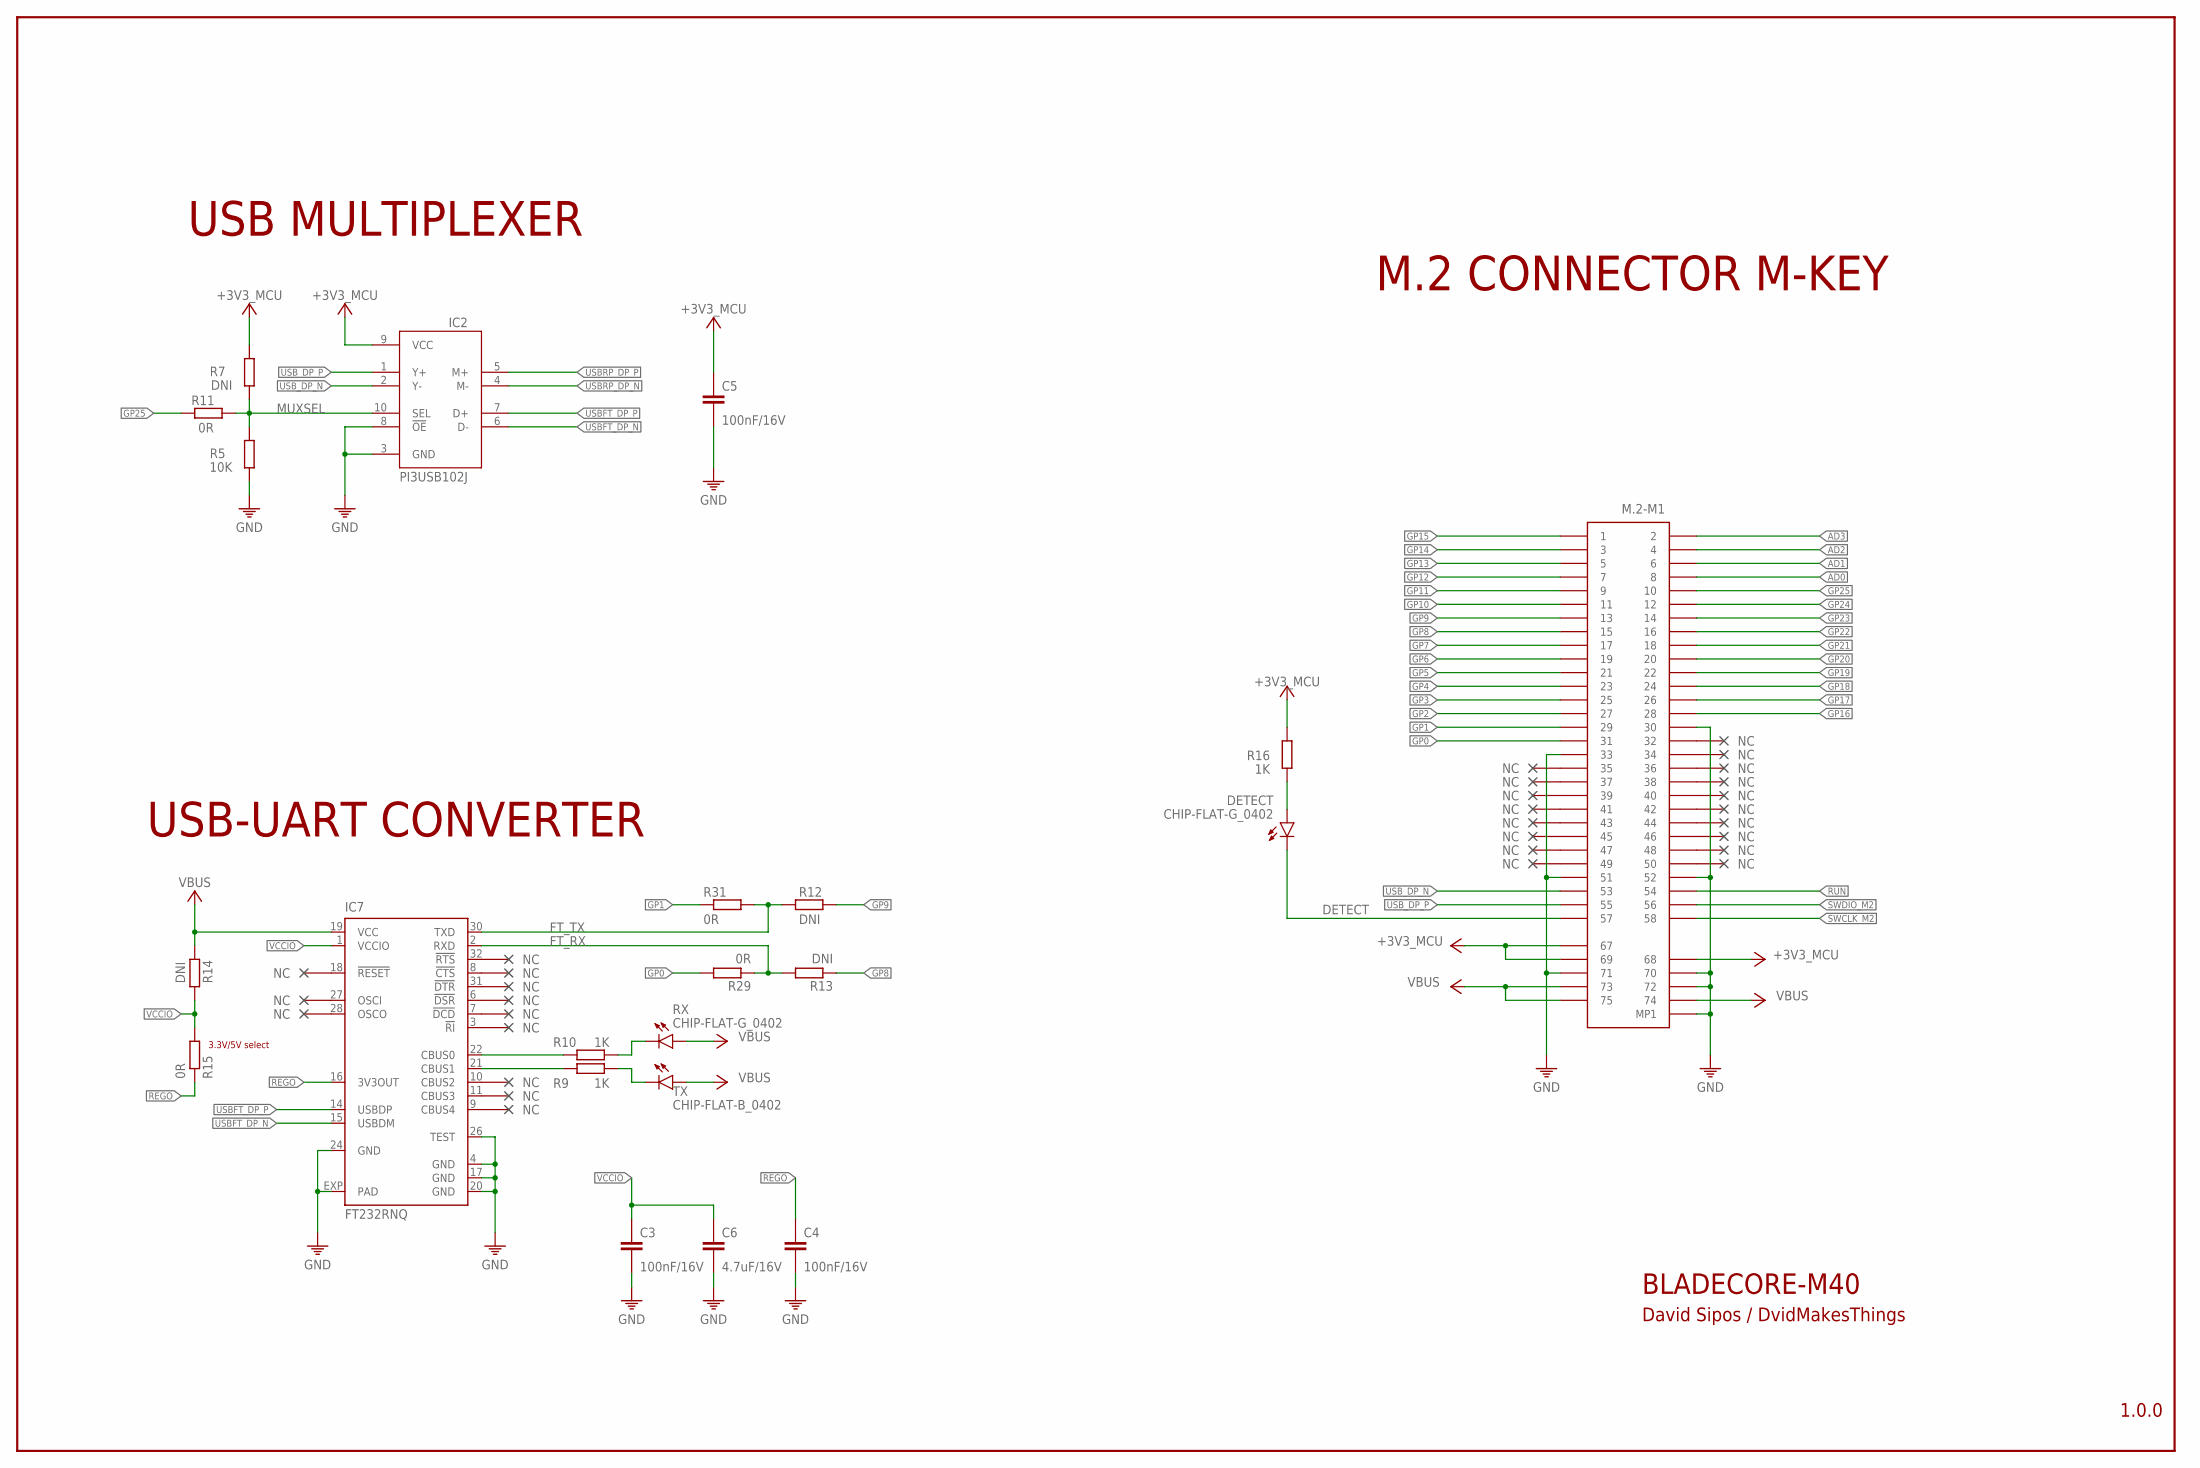
[picture p21: schematic BladeCore-M40.sch, sheet 2]

Parts:
C3, C4, C5: 100nF/16V; 0201
C6: 4.7uF/16V; 0201
DETECT: CHIP-FLAT-G_0402; LEDC1005X25N_FLAT-G
IC2: PI3USB102J; QFN40P120X140X35-10N
IC7: FT232RNQ; QFN32
M.2-M1: M.2-M-KEY
R5: 10K; R0201
R7, R12, R13, R14: DNI; R0201
R9, R10, R16: 1K; R0201
R11, R15, R29, R31: 0R; R0201
RX: CHIP-FLAT-G_0402; LEDC1005X25N_FLAT-G
TX: CHIP-FLAT-B_0402; LEDC1005X25N_FLAT-B

Connections:
+3V3_MCU: C5.1, IC2.9 (VCC), M.2-M1.P$67 (67), M.2-M1.P$68 (68), M.2-M1.P$69 (69), R7.2, R16.2; also elsewhere on the board
AD0: M.2-M1.P$8 (8); also elsewhere on the board
AD1: M.2-M1.P$6 (6); also elsewhere on the board
AD2: M.2-M1.P$4 (4); also elsewhere on the board
AD3: M.2-M1.P$2 (2); also elsewhere on the board
DETECT: DETECT.C, M.2-M1.P$57 (57)
FT_RX: IC7.2 (RXD), R13.2, R29.1
FT_TX: IC7.30 (TXD), R12.1, R31.2
GND: C3.2, C4.2, C5.2, C6.2, IC2.3 (GND), IC2.8 (!OE), IC7.4 (GND), IC7.17 (GND), IC7.20 (GND), IC7.24 (GND), IC7.26 (TEST), IC7.EXP (PAD), M.2-M1.MT1 (MP1), M.2-M1.P$30 (30), M.2-M1.P$33 (33), M.2-M1.P$51 (51), M.2-M1.P$52 (52), M.2-M1.P$70 (70), M.2-M1.P$71 (71), M.2-M1.P$72 (72), R5.1; also elsewhere on the board
GP0: M.2-M1.P$31 (31), R29.2; also elsewhere on the board
GP1: M.2-M1.P$29 (29), R31.1; also elsewhere on the board
GP2: M.2-M1.P$27 (27); also elsewhere on the board
GP3: M.2-M1.P$25 (25); also elsewhere on the board
GP4: M.2-M1.P$23 (23); also elsewhere on the board
GP5: M.2-M1.P$21 (21); also elsewhere on the board
GP6: M.2-M1.P$19 (19); also elsewhere on the board
GP7: M.2-M1.P$17 (17); also elsewhere on the board
GP8: M.2-M1.P$15 (15), R13.1; also elsewhere on the board
GP9: M.2-M1.P$13 (13), R12.2; also elsewhere on the board
GP10: M.2-M1.P$11 (11); also elsewhere on the board
GP11: M.2-M1.P$9 (9); also elsewhere on the board
GP12: M.2-M1.P$7 (7); also elsewhere on the board
GP13: M.2-M1.P$5 (5); also elsewhere on the board
GP14: M.2-M1.P$3 (3); also elsewhere on the board
GP15: M.2-M1.P$1 (1); also elsewhere on the board
GP16: M.2-M1.P$28 (28); also elsewhere on the board
GP17: M.2-M1.P$26 (26); also elsewhere on the board
GP18: M.2-M1.P$24 (24); also elsewhere on the board
GP19: M.2-M1.P$22 (22); also elsewhere on the board
GP20: M.2-M1.P$20 (20); also elsewhere on the board
GP21: M.2-M1.P$18 (18); also elsewhere on the board
GP22: M.2-M1.P$16 (16); also elsewhere on the board
GP23: M.2-M1.P$14 (14); also elsewhere on the board
GP24: M.2-M1.P$12 (12); also elsewhere on the board
GP25: M.2-M1.P$10 (10), R11.2; also elsewhere on the board
MUXSEL: IC2.10 (SEL), R5.2, R7.1, R11.1
unnamed: DETECT.A, R16.1
unnamed: IC7.22 (CBUS0), R10.1
unnamed: IC7.21 (CBUS1), R9.1
unnamed: R9.2, TX.C
unnamed: R10.2, RX.C
REGO: C4.1, IC7.16 (3V3OUT), R15.1
RUN: M.2-M1.P$54 (54); also elsewhere on the board
SWCLK_M2: M.2-M1.P$58 (58); also elsewhere on the board
SWDIO_M2: M.2-M1.P$56 (56); also elsewhere on the board
USBFT_DP_N: IC2.6 (D-), IC7.15 (USBDM)
USBFT_DP_P: IC2.7 (D+), IC7.14 (USBDP)
USBRP_DP_N: IC2.4 (M-); also elsewhere on the board
USBRP_DP_P: IC2.5 (M+); also elsewhere on the board
USB_DP_N: IC2.2 (Y-), M.2-M1.P$53 (53)
USB_DP_P: IC2.1 (Y+), M.2-M1.P$55 (55)
VBUS: IC7.19 (VCC), M.2-M1.P$73 (73), M.2-M1.P$74 (74), M.2-M1.P$75 (75), R14.2, RX.A, TX.A; also elsewhere on the board
VCCIO: C3.1, C6.1, IC7.1 (VCCIO), R14.1, R15.2

Notes on the sheet:
3.3V/5V select
USB MULTIPLEXER
USB-UART CONVERTER
M.2 CONNECTOR M-KEY
BLADECORE-M40
1.0.0
David Sipos / DvidMakesThings

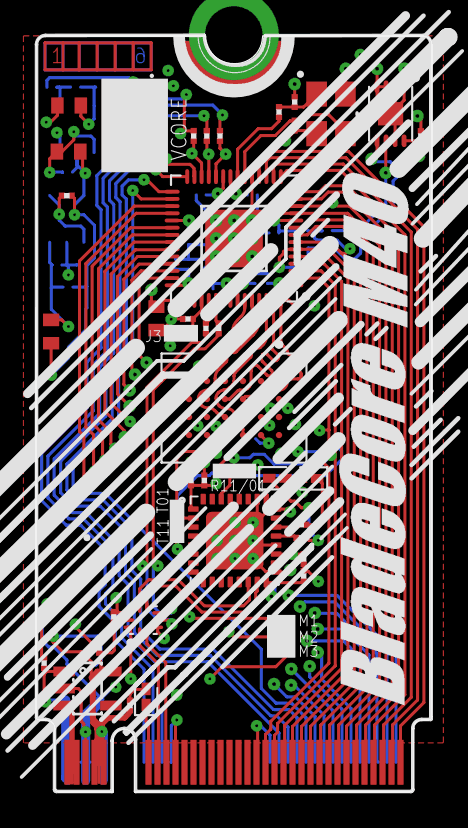
[picture p22: board BladeCore-M40.brd from above]

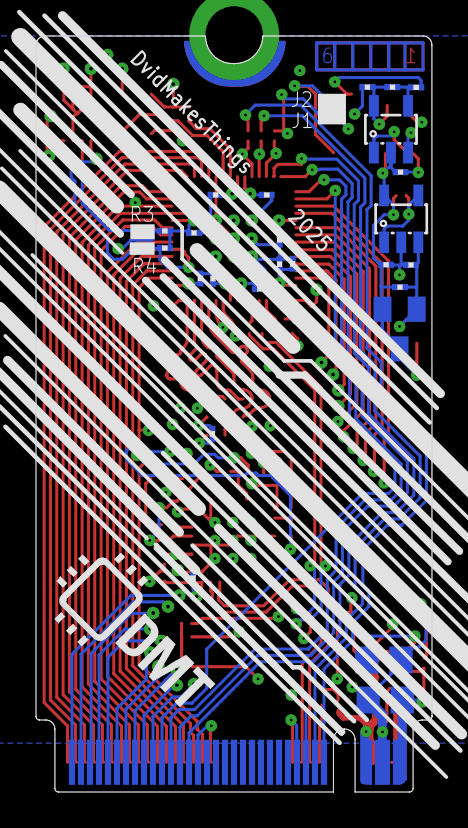
[picture p23: board BladeCore-M40.brd from below]

Board: 6 copper layers, 22.0 x 42.0 mm, 76 parts (31 on the bottom side), 75 nets.

Other parts of the board:
U$1: DMT
