DvidMakesThings/HW_BladeCoreMxx/(commit log)

2025-05-16 M40 design files
    [BladeCore-M40.brd, BladeCore-M40.sch, BladeCore-M54.sch]
2025-05-29 Finish M40 design
    [BladeCore-M40.brd, BladeCore-M40.sch, BladeCore-M40_bom.csv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]
2025-05-30 update gerbers
    [BladeCore-M40.brd, BladeCore-M40_bom.csv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]
2025-06-02 Start with M54
    [BladeCore-M40.brd, BladeCore-M40.sch, BladeCore-M40_bom.csv, BladeCore-M54.brd, BladeCore-M54.sch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]
