DvidMakesThings/HW_BladeCoreMxx/(notices)

Notices in the files:
parts and their libraries:
Wurth_Quartz Crystals: Copyright: Würth Elektronik
